thomastech/CAN2Cluster/Schematics/README.md

# CAN2Cluster Schematic Files
### Information:
The schematic set consists of five page sheets in common PDF format. Please download all pages.

This isn't a "beginner" electronic project and simple pictorial wiring diagrams are not available. But 
the drawings include color graphic images to assist wiring the modules together.
