thomastech/CAN2Cluster/Schematics/Page5.pdf

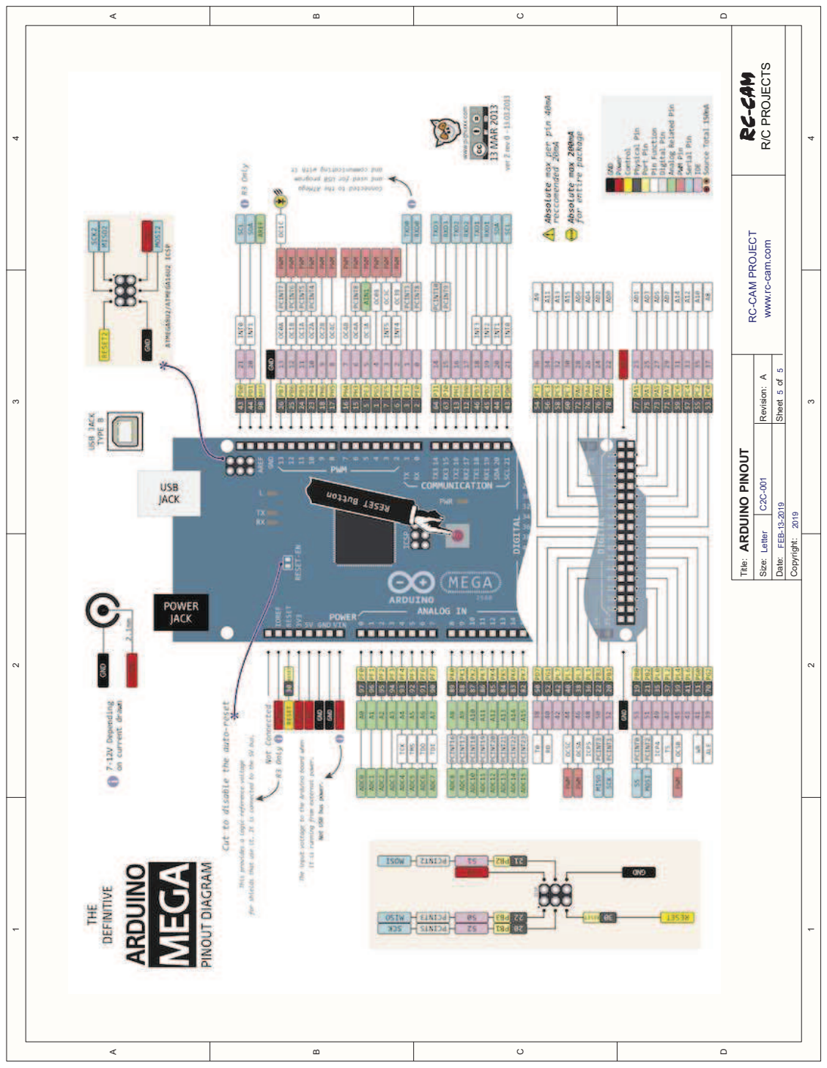
[picture p1: page 1]

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
ARDUINO PINOUT

C2C-001 A

Title:

Size:

Date:

Revision:

Sheet of

Letter

## R/C PROJECTS

### RC-CAM PROJECT

### www.rc-cam.com

Copyright:

FEB-13-2019
2019
