thomastech/CAN2Cluster/PartsList.md

# **CAN2Cluster Parts List**  
**Summary:** The basic electrical components used in the project are listed here. For convenience, links to eBay and AliExpress are provided. There's no obligation to use these sources; Feel free to buy from your preferred suppliers.  

**The Small Print:** Don't worry, the URLs are NOT sneaky affiliate links. I don't profit from your clicks.

**Important Notes:** Most of the parts have similar looking variants that may not be compatible with the project. Therefore, consult the photos shown below to confirm you are buying the exact item needed.  

**Fatherly Advice:** Most of the items are inexpensive, so it is highly recommended to add a spare to your order in case of electrical "accidents."

* **2007-2009 Ford Mustang Instrument Cluster, 6-Gauge**  
Contact your local (or favorite online) Auto Wrecker  
mustangcluster275

* **Arduino MEGA 2560 R3 (Qty 1)**  
eBay: https://goo.gl/4xZTBC  
AliExpress: https://goo.gl/kTr3pV  
arduinomega_450  
  
* **MCP2515 / TJA1050 CAN-Bus Modules (Qty 2)**  
eBay: https://goo.gl/GTtTwe   
AliExpress: https://goo.gl/YxtGXm  
can-bus_bd1_300  

* **2.54mm 2x13 Double Row Header Connector, 26-Pins (Qty 1)**  
eBay:  https://goo.gl/N29kqw  
AliExpress: https://goo.gl/JDQtrA  
header26p_300  

* **2-Channel 12V Relay with Optocoupler and High/Low Trigger (Qty 1)**  
eBay: https://goo.gl/ZCKwSc  
AliExpress: https://goo.gl/SmE6uS  
relay2ch_1_300  

* **IRF520 MOSFET Module (Qty 1)**  
eBay: https://goo.gl/TvqrgT  
AliExpress: https://goo.gl/Hgeu83  
mosfet1_300

* **IR Remote Control (Qty 1)**  
eBay: https://goo.gl/qJMWHw  
AliExpress: https://goo.gl/JkNyxD  
ir_remote1_250

* **DFPlayer Mini SD Card MP3 Player (Qty 1)**  
eBay: https://goo.gl/hcQCzf  
AliExpress: https://goo.gl/zCSGiU   
dfplayermodule_300

* **TDA7297 2x15W Audio Amplifier (Qty 1)**  
eBay: https://goo.gl/ojjMuu  
AliExpress: https://goo.gl/QQc5oA  
amplifier1_300  

* **Automobile Ignition Switch with Keys, 2 Position (Qty 1)**  
eBay: https://goo.gl/HmX2tG  
AliExpress: https://goo.gl/je7H8e  
ignswitch1_300  

* **Stereo Car Speakers (Qty 1)**  
eBay: https://goo.gl/ia1zvL  
Amazon USA: https://goo.gl/3653YV  
speakers1_300
