thomastech/CAN2Cluster/Schematics/Page1.pdf

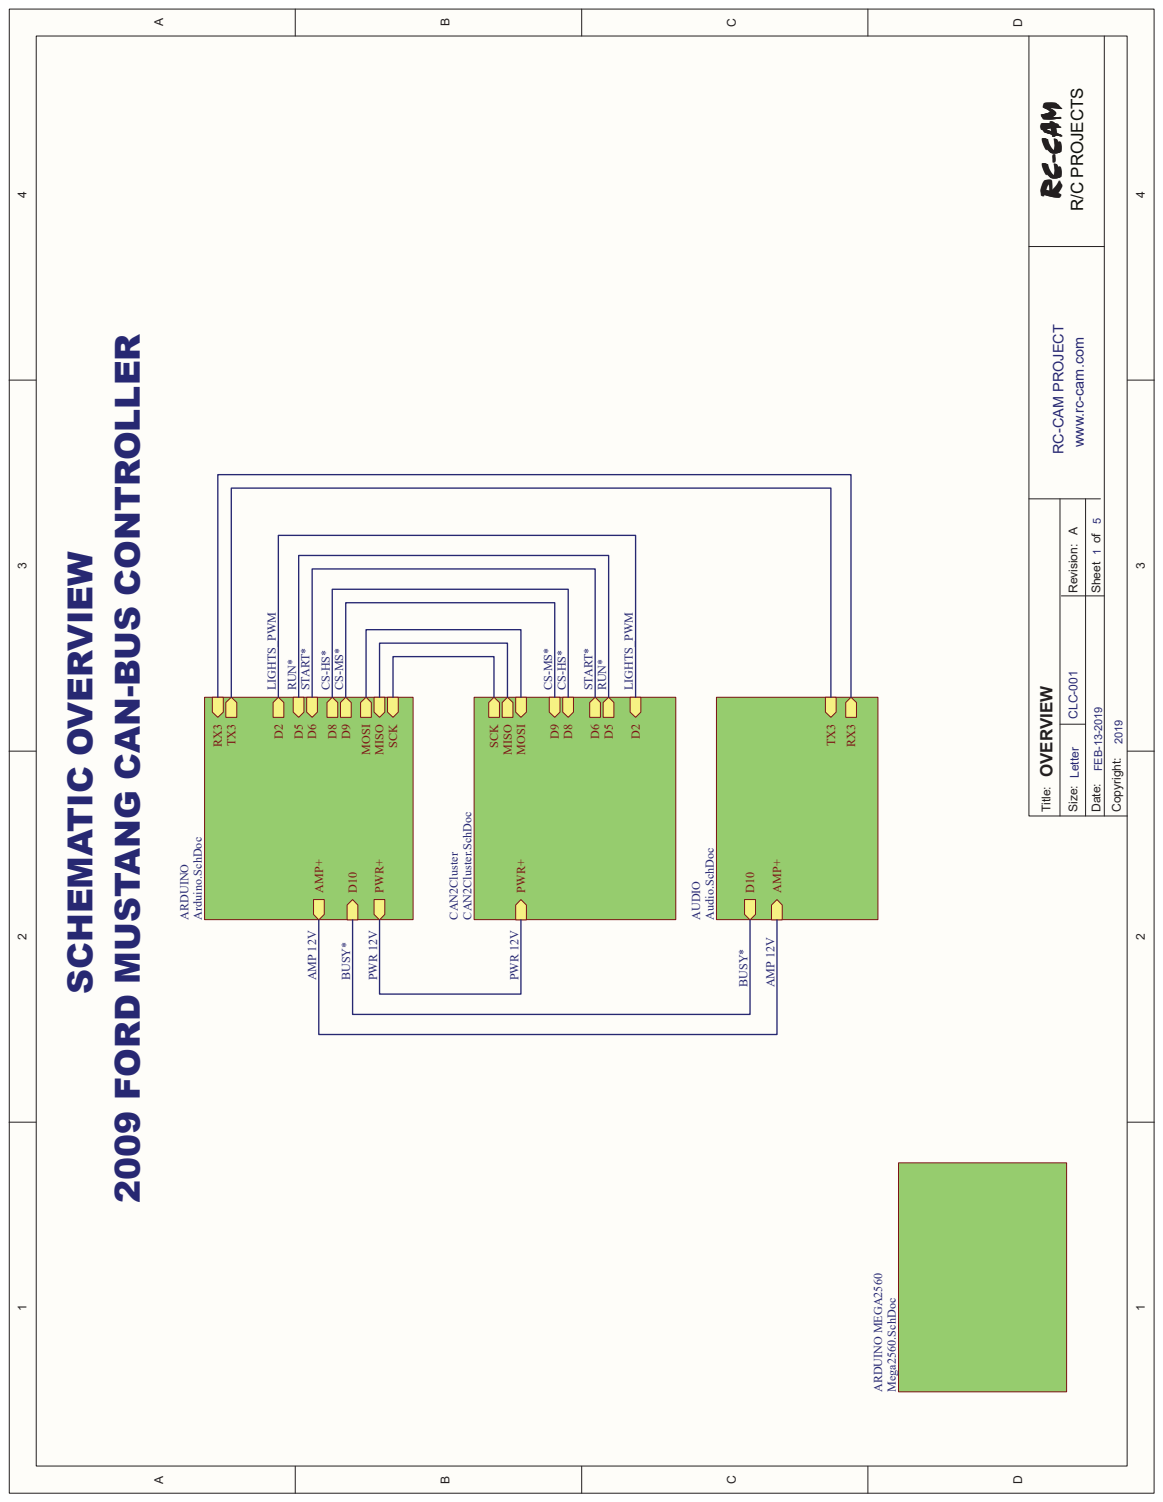
[picture p2: page 1]
OVERVIEW; CLC-001 A; Title:; Size:; Date:; Revision:; Sheet of; Letter; R/C PROJECTS; Copyright:; FEB-13-2019; MOSI; MISO; SCK; AMP+; PWR+; ARDUINO; Arduino.SchDoc; CAN2Cluster; CAN2Cluster.SchDoc; AUDIO; Audio.SchDoc; ARDUINO MEGA2560; Mega2560.SchDoc; BUSY*; LIGHTS_PWM; START*; RUN*; AMP 12V; PWR 12V

RC-CAM PROJECT

www.rc-cam.com
