thomastech/CAN2Cluster/Schematics/Page2.pdf

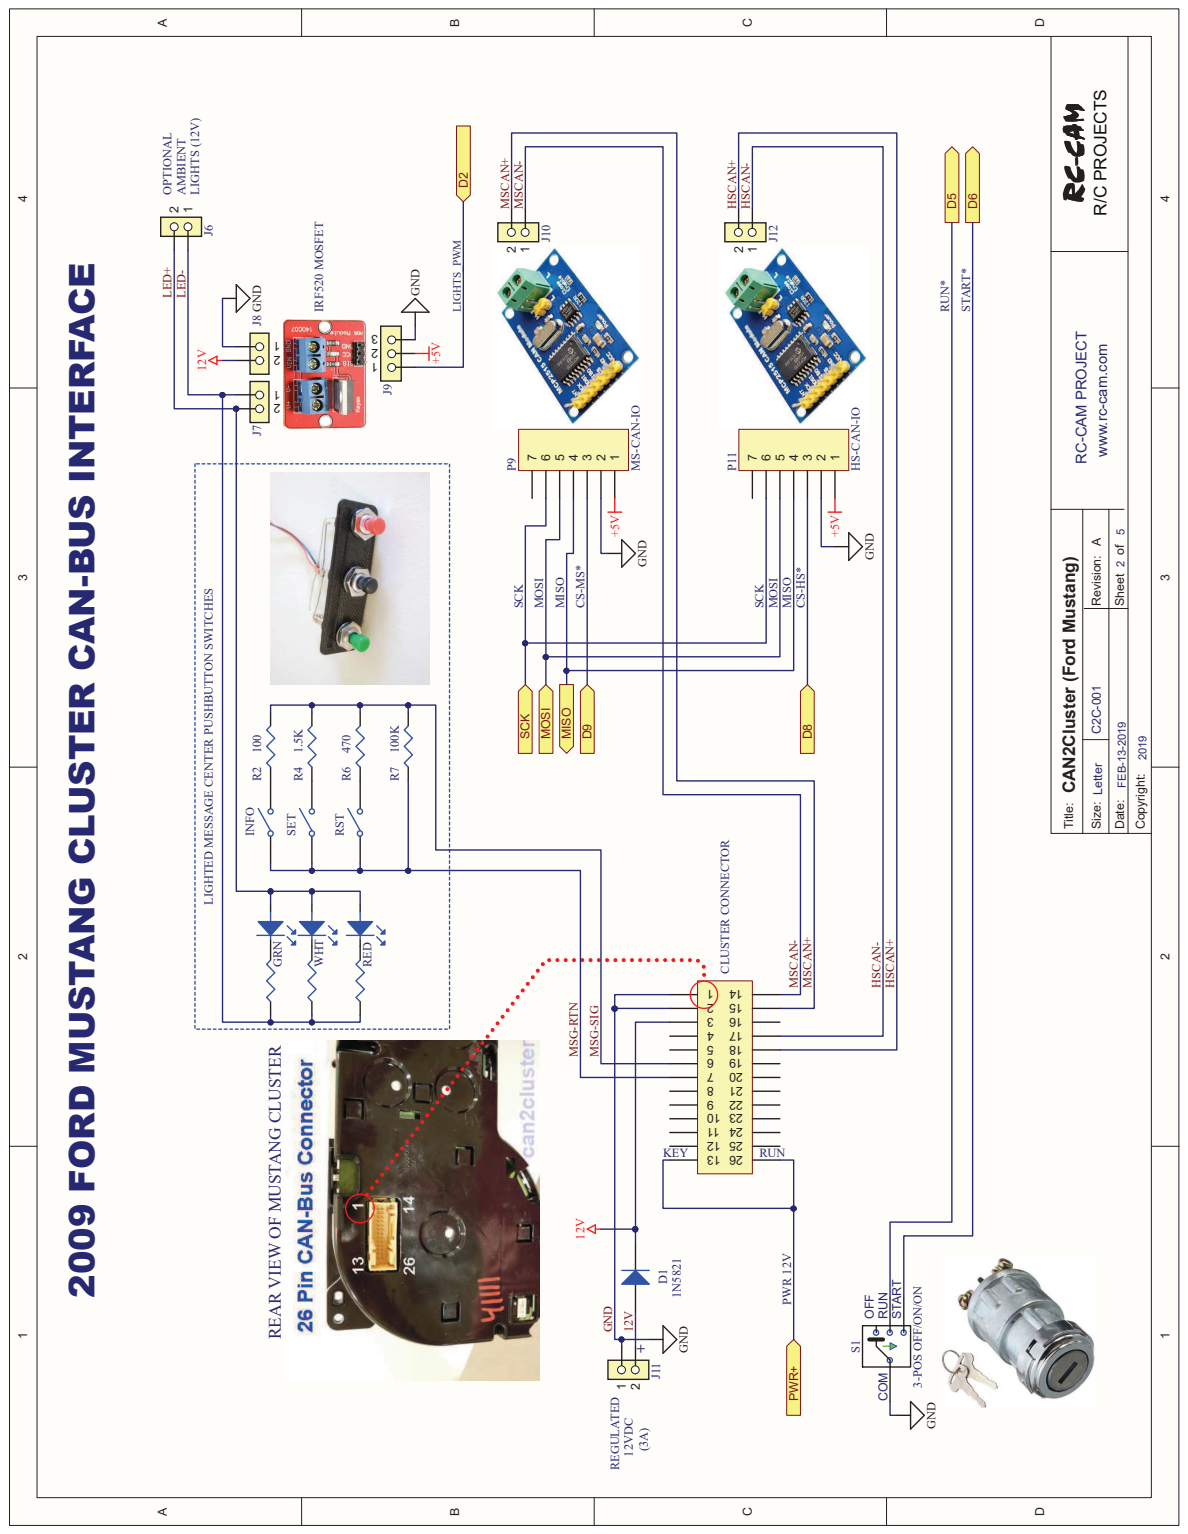
[picture p3: page 1]

www.rc-cam.com

LIGHTED MESSAGE CENTER PUSHBUTTON SWITCHES

REAR VIEW OF MUSTANG CLUSTER

3-POS OFF/ON/ON
