thomastech/CAN2Cluster/Schematics/Page3.pdf

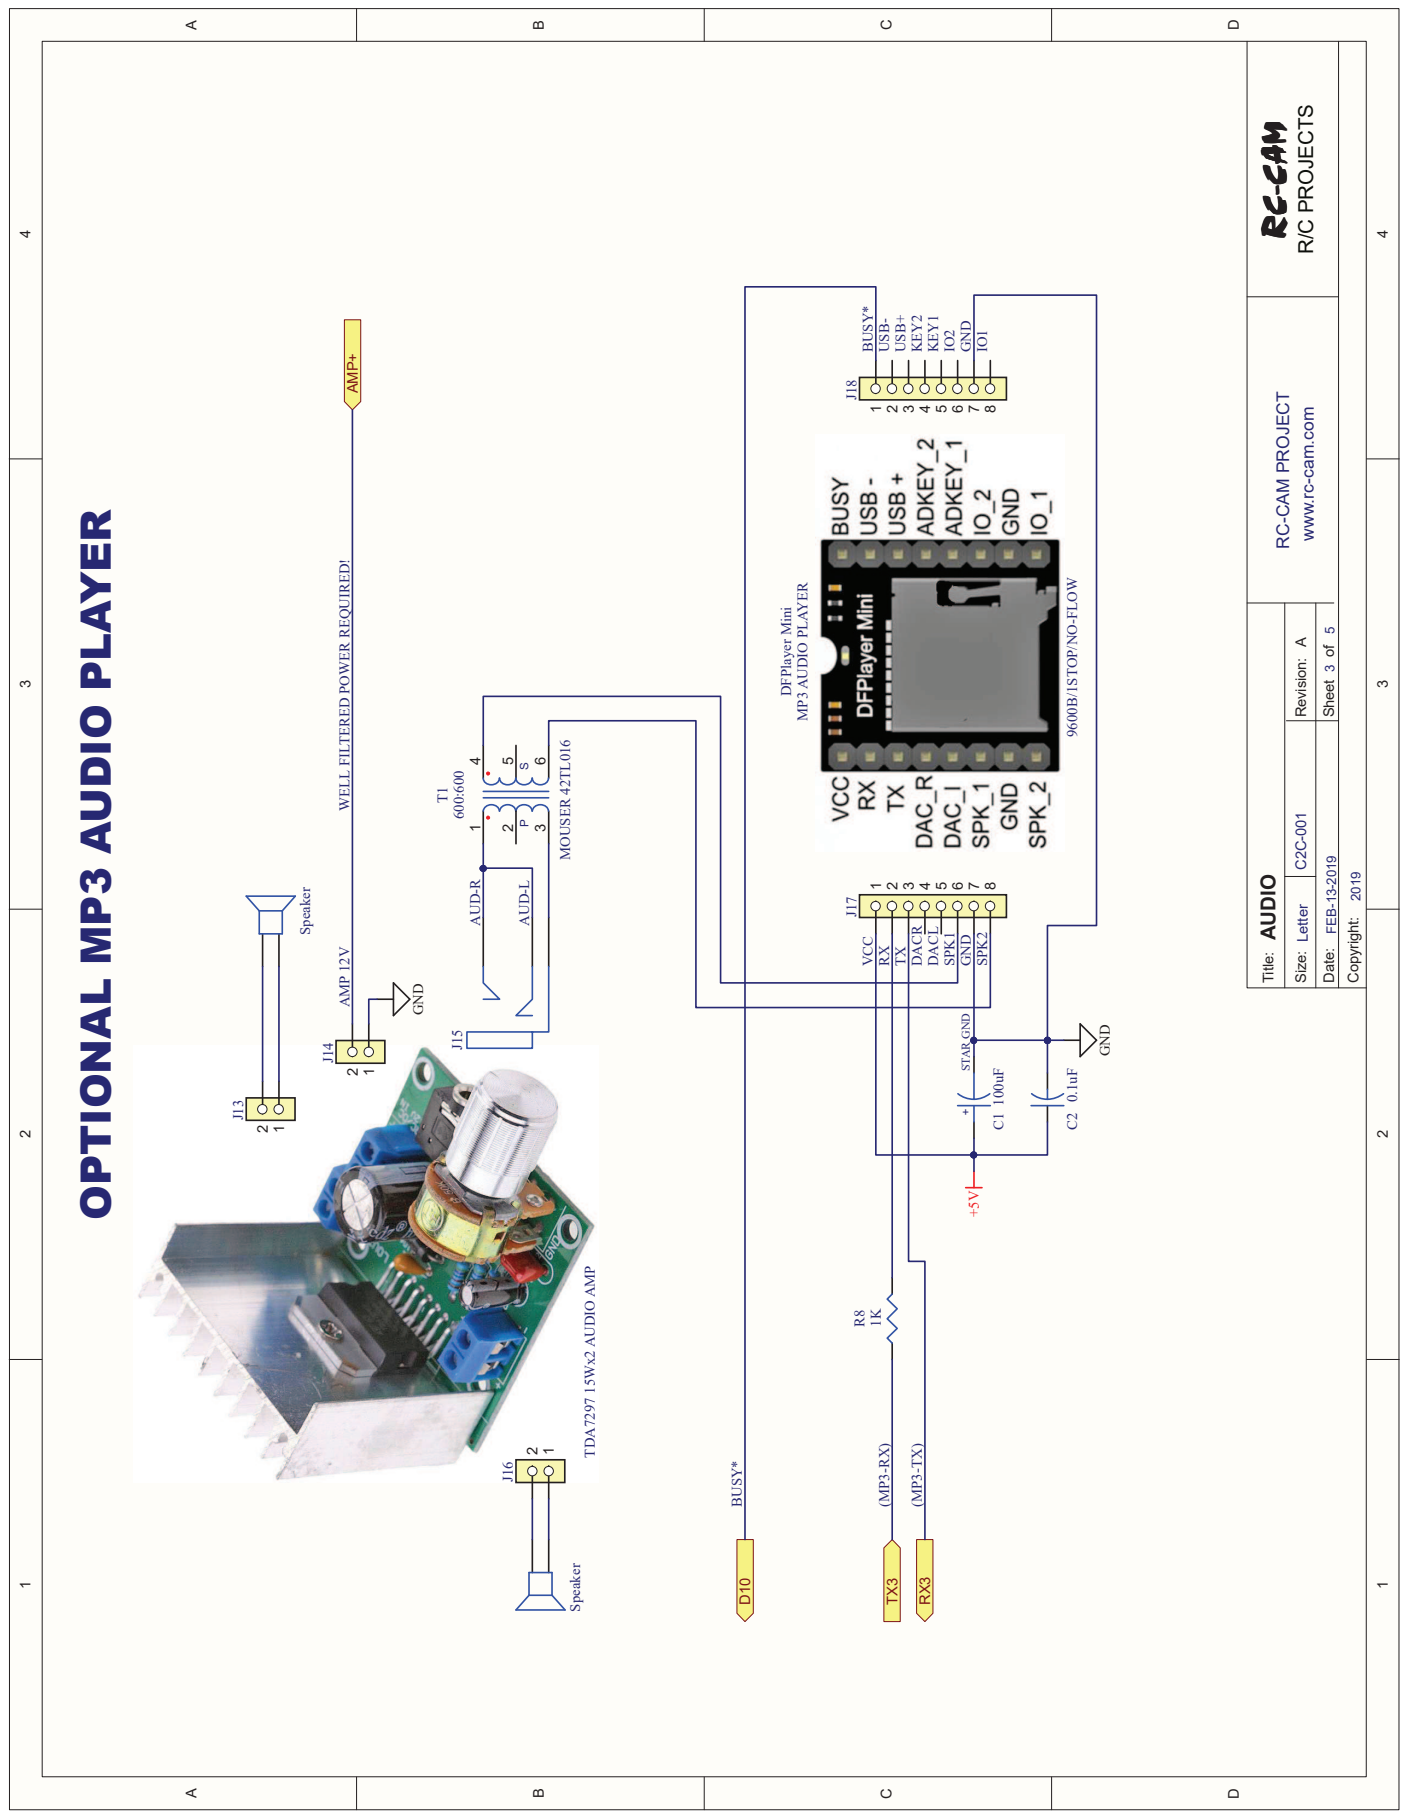
[picture p4: page 1]

www.rc-cam.com

WELL FILTERED POWER REQUIRED!
