thomastech/CAN2Cluster/Schematics/Page4.pdf

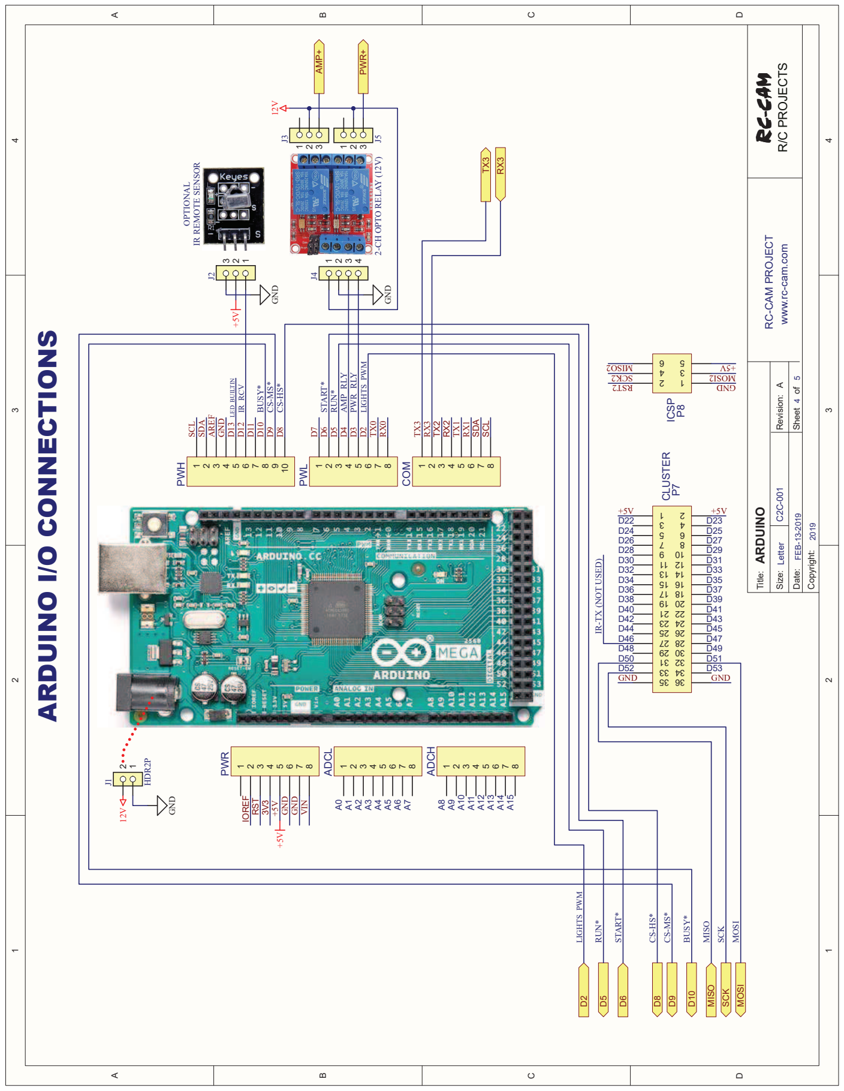
[picture p5: page 1]

www.rc-cam.com

IR-TX (NOT USED)
