thomastech/CAN2Cluster/Arduino/Sequencer.h

// File: Sequencer.h. Used in Can2Cluster.ino project.
// Purpose: Animation Sequencer Structures and Data.
// Author: T. Black
// Created: Jan-07-2019
// Last Change: Feb-20-2019
/*
   GNU GENERAL PUBLIC LICENSE VERSION 3
   Copyright (C) 2019  T. Black
   This file is part of Can2Cluster_Ford.ino (hereby referred to as Can2Cluster).
   
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
   You should have received a copy of the GNU General Public License
   along with Can2Cluster.  If not, see <https://www.gnu.org/licenses/>.
*/

//
// ============================================================================================================================

#define SEQ_DATA_CNT    6                               // Number of Data Columns in a Sequencer Array Map's Row.
#define SEQUENCE_DLY    100                             // Delay time between Animation steps, in mS.
#define SEQ_DRV_STEPS   ((sizeof(SequencerDrive))/sizeof(SequencerDrive[0]))
#define SEQ_FIXED_STEPS ((sizeof(SequencerFixed))/sizeof(SequencerFixed[0]))
#define SEQ_REV1_STEPS  ((sizeof(SequencerRev1))/sizeof(SequencerRev1[0]))
#define SEQ_REV2_STEPS  ((sizeof(SequencerRev2))/sizeof(SequencerRev2[0]))
#define SEQ_STOP_STEPS  ((sizeof(SequencerStop))/sizeof(SequencerStop[0]))
#define SEQ_TEST_STEPS  ((sizeof(SequencerTest))/sizeof(SequencerTest[0]))
#define SEQ_USER1_STEPS ((sizeof(SequencerUser1))/sizeof(SequencerTest[0]))
#define SEQ_USER2_STEPS ((sizeof(SequencerUser2))/sizeof(SequencerTest[0]))

// ============================================================================================================================
//       DATA ARRAY MAP FORMATTING NOTES
// Data order is <SPEED>, <RPM/100>, <COOLANT TEMPERATURE>, <OIL PRESSURE>, <CHARGE INDICATOR>
// SPEED      = 0-120 (MPH)
// RPM        = 0-70 (0-7000)
// TEMPERATURE= COLD_TEMP, COOL_TEMP, LOW_TEMP, MID_TEMP, WARM_TEMP, HIGH_TEMP, OVER_TEMP
// OIL PRESS  = OIL_OFF, OIL_ON
// CHARGE IND = CHARGE_OFF, CHARGE_ON
// BRAKE IND  = BRAKE_OFF, BRAKE_ON
// ============================================================================================================================
//           USER DEFINED PRE-SETS
// Feel free to configure these to your preferred gauge configuration. Multiple data rows allowed (to create animation).
// Sequences start with BRAKE_OFF, followed by BRAKE_ON. This is used to initialize the brake indicator.
// User Pre-Set #1 Sequence Array Map.
//  {SPD-RPMX100-TEMP-OILPRS--CHARGE---BRAKE----}
const byte PROGMEM SequencerUser1[][SEQ_DATA_CNT] = {
    {0,0,OVER_TEMP,OIL_ON,CHARGE_OFF,BRAKE_OFF},
    {0,0,OVER_TEMP,OIL_ON,CHARGE_OFF,BRAKE_ON},
    {0,0,OVER_TEMP,OIL_ON,CHARGE_OFF,BRAKE_OFF},
    {120,70,OVER_TEMP,OIL_ON,CHARGE_OFF,BRAKE_OFF},
};

// User Pre-Set #2 Sequence Array Map.
//  SPD-RPMX100-TEMP-OILPRS--CHARGE---BRAKE----
const byte PROGMEM SequencerUser2[][SEQ_DATA_CNT] = {
    {0,0,HIGH_TEMP,OIL_ON,CHARGE_OFF,BRAKE_OFF},
    {0,0,HIGH_TEMP,OIL_ON,CHARGE_OFF,BRAKE_ON},
    {0,0,HIGH_TEMP,OIL_ON,CHARGE_OFF,BRAKE_OFF},
    {20,10,HIGH_TEMP,OIL_ON,CHARGE_OFF,BRAKE_OFF}
};

// ============================================================================================================================
//          ANIMATION SEQUENCER MAPS (Data rows are executed at 100mS intervals)

// Long Playing Engine Rev #1 Animation Sequence Array Map.
// This animation uses MP3 File MP3_FILE_REV1
//  SPD-RPMX100-TEMP-OILPRS--CHARGE---BRAKE----
const byte PROGMEM SequencerRev1[][SEQ_DATA_CNT] = {
    { 0, 0,COOL_TEMP,OIL_OFF,CHARGE_ON,BRAKE_ON},       // TIME 0S
    { 0, 0,COOL_TEMP,OIL_OFF,CHARGE_ON,BRAKE_ON},
    { 0, 0,COOL_TEMP,OIL_OFF,CHARGE_ON,BRAKE_ON},
    { 0, 0,COOL_TEMP,OIL_OFF,CHARGE_ON,BRAKE_ON},
    { 0, 0,COOL_TEMP,OIL_ON,CHARGE_OFF,BRAKE_ON},
    { 0, 0,COOL_TEMP,OIL_ON,CHARGE_OFF,BRAKE_ON},
    { 0, 6,COOL_TEMP,OIL_ON,CHARGE_OFF,BRAKE_ON},
    { 0, 7,COOL_TEMP,OIL_ON,CHARGE_OFF,BRAKE_ON},
    { 0, 6,COOL_TEMP,OIL_ON,CHARGE_OFF,BRAKE_ON},
    { 0, 7,COOL_TEMP,OIL_ON,CHARGE_OFF,BRAKE_ON},
    
    { 0, 6,COOL_TEMP,OIL_ON,CHARGE_OFF,BRAKE_ON},       // TIME 1S
    { 0, 7,COOL_TEMP,OIL_ON,CHARGE_OFF,BRAKE_ON},
    { 0, 6,COOL_TEMP,OIL_ON,CHARGE_OFF,BRAKE_ON},
    { 0, 5,COOL_TEMP,OIL_ON,CHARGE_OFF,BRAKE_ON},
    { 0, 6,COOL_TEMP,OIL_ON,CHARGE_OFF,BRAKE_ON},
    { 0, 7,COOL_TEMP,OIL_ON,CHARGE_OFF,BRAKE_ON},
    { 0, 6,COOL_TEMP,OIL_ON,CHARGE_OFF,BRAKE_ON},
    { 0, 5,COOL_TEMP,OIL_ON,CHARGE_OFF,BRAKE_ON},
    { 0, 6,COOL_TEMP,OIL_ON,CHARGE_OFF,BRAKE_ON},
    { 0, 7,COOL_TEMP,OIL_ON,CHARGE_OFF,BRAKE_ON},
    
    { 0, 6,COOL_TEMP,OIL_ON,CHARGE_OFF,BRAKE_ON},       // TIME 2S
    { 0, 5,COOL_TEMP,OIL_ON,CHARGE_OFF,BRAKE_ON},
    { 0, 6,COOL_TEMP,OIL_ON,CHARGE_OFF,BRAKE_ON},
    { 0, 7,COOL_TEMP,OIL_ON,CHARGE_OFF,BRAKE_ON},
    { 0, 6,COOL_TEMP,OIL_ON,CHARGE_OFF,BRAKE_ON},
    { 0, 6,COOL_TEMP,OIL_ON,CHARGE_OFF,BRAKE_ON},
    { 0, 6,COOL_TEMP,OIL_ON,CHARGE_OFF,BRAKE_ON},
    { 0, 5,COOL_TEMP,OIL_ON,CHARGE_OFF,BRAKE_ON},
    { 0, 5,COOL_TEMP,OIL_ON,CHARGE_OFF,BRAKE_ON},
    { 0, 5,COOL_TEMP,OIL_ON,CHARGE_OFF,BRAKE_ON},
    
    { 0,40,COOL_TEMP,OIL_ON,CHARGE_OFF,BRAKE_ON},       // TIME 3S
    { 0,40,COOL_TEMP,OIL_ON,CHARGE_OFF,BRAKE_ON},
    { 0,40,COOL_TEMP,OIL_ON,CHARGE_OFF,BRAKE_ON},
    { 0,40,COOL_TEMP,OIL_ON,CHARGE_OFF,BRAKE_ON},
    { 0,40,COOL_TEMP,OIL_ON,CHARGE_OFF,BRAKE_ON},
    { 0,40,COOL_TEMP,OIL_ON,CHARGE_OFF,BRAKE_ON},
    { 0,20,COOL_TEMP,OIL_ON,CHARGE_OFF,BRAKE_ON},
    { 0,15,COOL_TEMP,OIL_ON,CHARGE_OFF,BRAKE_ON},
    { 0,10,COOL_TEMP,OIL_ON,CHARGE_OFF,BRAKE_ON},
    { 0, 7,COOL_TEMP,OIL_ON,CHARGE_OFF,BRAKE_ON},

    { 0, 7,LOW_TEMP,OIL_ON,CHARGE_OFF,BRAKE_ON},        // TIME 4S
    { 0,45,LOW_TEMP,OIL_ON,CHARGE_OFF,BRAKE_ON},
    { 0,42,LOW_TEMP,OIL_ON,CHARGE_OFF,BRAKE_ON},
    { 0,46,LOW_TEMP,OIL_ON,CHARGE_OFF,BRAKE_ON},
    { 0,48,LOW_TEMP,OIL_ON,CHARGE_OFF,BRAKE_ON},
    { 0,45,LOW_TEMP,OIL_ON,CHARGE_OFF,BRAKE_ON},
    { 0,48,LOW_TEMP,OIL_ON,CHARGE_OFF,BRAKE_ON},
    { 0,42,LOW_TEMP,OIL_ON,CHARGE_OFF,BRAKE_ON},
    { 0,30,LOW_TEMP,OIL_ON,CHARGE_OFF,BRAKE_ON},
    { 0,20,LOW_TEMP,OIL_ON,CHARGE_OFF,BRAKE_ON},
    
    { 0,10,LOW_TEMP,OIL_ON,CHARGE_OFF,BRAKE_ON},        // TIME 5S
    { 0, 9,LOW_TEMP,OIL_ON,CHARGE_OFF,BRAKE_ON},
    { 0, 8,LOW_TEMP,OIL_ON,CHARGE_OFF,BRAKE_ON},
    { 0, 7,LOW_TEMP,OIL_ON,CHARGE_OFF,BRAKE_ON},
    { 0, 6,LOW_TEMP,OIL_ON,CHARGE_OFF,BRAKE_ON},
    { 0, 7,LOW_TEMP,OIL_ON,CHARGE_OFF,BRAKE_ON},
    { 0, 6,LOW_TEMP,OIL_ON,CHARGE_OFF,BRAKE_ON},
    { 0, 5,LOW_TEMP,OIL_ON,CHARGE_OFF,BRAKE_ON},
    { 0, 42,LOW_TEMP,OIL_ON,CHARGE_OFF,BRAKE_ON},
    { 0, 40,LOW_TEMP,OIL_ON,CHARGE_OFF,BRAKE_ON},

    { 0,38,LOW_TEMP,OIL_ON,CHARGE_OFF,BRAKE_ON},        // TIME 6S
    { 0,30,LOW_TEMP,OIL_ON,CHARGE_OFF,BRAKE_ON},
    { 0,15,LOW_TEMP,OIL_ON,CHARGE_OFF,BRAKE_ON},
    { 0,10,LOW_TEMP,OIL_ON,CHARGE_OFF,BRAKE_ON},
    { 0,12,LOW_TEMP,OIL_ON,CHARGE_OFF,BRAKE_ON},
    { 0,12,LOW_TEMP,OIL_ON,CHARGE_OFF,BRAKE_ON},
    { 0,38,LOW_TEMP,OIL_ON,CHARGE_OFF,BRAKE_ON},
    { 0,38,LOW_TEMP,OIL_ON,CHARGE_OFF,BRAKE_ON},
    { 0,36,LOW_TEMP,OIL_ON,CHARGE_OFF,BRAKE_ON},
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
    { 5, 5,HIGH_TEMP,OIL_OFF,CHARGE_OFF,BRAKE_OFF},
    { 5, 5,HIGH_TEMP,OIL_OFF,CHARGE_OFF,BRAKE_OFF},
    { 5, 5,HIGH_TEMP,OIL_OFF,CHARGE_OFF,BRAKE_OFF},
    { 5, 5,HIGH_TEMP,OIL_OFF,CHARGE_OFF,BRAKE_OFF},
    { 0, 0,MED_TEMP,OIL_OFF,CHARGE_ON,BRAKE_ON}
    };


// Engine Stopped Animation Sequence Array Map.
// Does not use a MP3 file.
//  SPD-RPMX100-TEMP-OILPRS--CHARGE---BRAKE----
const byte PROGMEM SequencerStop[][SEQ_DATA_CNT] = {
    { 0, 0,LOW_TEMP,OIL_OFF,CHARGE_ON,BRAKE_OFF},
    { 0, 0,LOW_TEMP,OIL_OFF,CHARGE_ON,BRAKE_OFF},
    { 0, 0,LOW_TEMP,OIL_OFF,CHARGE_ON,BRAKE_OFF},
    { 0, 0,LOW_TEMP,OIL_OFF,CHARGE_ON,BRAKE_OFF},
    { 0, 0,LOW_TEMP,OIL_OFF,CHARGE_ON,BRAKE_OFF},
    { 0, 0,LOW_TEMP,OIL_OFF,CHARGE_ON,BRAKE_OFF},
    { 0, 0,LOW_TEMP,OIL_OFF,CHARGE_ON,BRAKE_ON}
};

// Fixed Speed/RPM Animation Sequence Array Map.
// Zero Gauge then Set to 60mph, 3500RPM
// This anmimation uses file MP3_FILE_FIX.
//  SPD-RPMX100-TEMP-OILPRS--CHARGE---BRAKE----
const byte PROGMEM SequencerFixed[][SEQ_DATA_CNT] = {
    { 0, 0,COLD_TEMP,OIL_ON,CHARGE_OFF,BRAKE_ON},       // Time 0S
    { 0, 0,COLD_TEMP,OIL_ON,CHARGE_OFF,BRAKE_ON},
    { 0, 0,COLD_TEMP,OIL_ON,CHARGE_OFF,BRAKE_ON},
    { 0, 0,COLD_TEMP,OIL_ON,CHARGE_OFF,BRAKE_ON},
    { 0, 0,COLD_TEMP,OIL_ON,CHARGE_OFF,BRAKE_OFF},
    { 0, 0,COLD_TEMP,OIL_ON,CHARGE_OFF,BRAKE_OFF},
    { 5, 3,COOL_TEMP,OIL_ON,CHARGE_OFF,BRAKE_OFF},
    {10, 6,COOL_TEMP,OIL_ON,CHARGE_OFF,BRAKE_OFF},
    {15, 9,COOL_TEMP,OIL_ON,CHARGE_OFF,BRAKE_OFF},
    
    {20,12,COOL_TEMP,OIL_ON,CHARGE_OFF,BRAKE_OFF},      // Time 1S
    {25,15,COOL_TEMP,OIL_ON,CHARGE_OFF,BRAKE_OFF},
    {30,18,COOL_TEMP,OIL_ON,CHARGE_OFF,BRAKE_OFF},
    {35,21,MED_TEMP,OIL_ON,CHARGE_OFF,BRAKE_OFF},
    {40,24,MED_TEMP,OIL_ON,CHARGE_OFF,BRAKE_OFF},
    {45,27,MED_TEMP,OIL_ON,CHARGE_OFF,BRAKE_OFF},
    {50,30,MED_TEMP,OIL_ON,CHARGE_OFF,BRAKE_OFF},
    {55,33,MED_TEMP,OIL_ON,CHARGE_OFF,BRAKE_OFF},
    {60,35,MED_TEMP,OIL_ON,CHARGE_OFF,BRAKE_OFF}

};
