thomastech/CAN2Cluster/(commit log)

2019-01-11 Minor edits, fix CAN-Bus capitalizations
2019-02-15 Updated project status, added estimated Arduino Code release date.
2019-03-21 Release Update V1.1 Source Files
    V1.1 Update Summary:
    All unchanged files remain at V1.0.
    Allow instrument cluster to fully sleep when it is turned off. This reduces current consumption when not in use.
    Backlight now off when cluster is off.
2024-03-18 Added 3D Printer STL files
    The 3D-Print_Files.zip file contains the STL files to all the 3D printed parts used by the author.
2024-03-18 Update README.md
    Added information about the recently uploaded 3D Printer STL files.
2026-10-18 Minor Bug Fixes, Release V1.4
    Minor Fixes, Release V1.4
    Note: V1.2 - V1.3 were not public releases (dev only).
    Corrected millis() and micros() usage to prevent wrap rollovers.
    Fixed EngineStartUp() function, improved switch debounce.
